baltic-racing/ADaMM-Accumulator-Distribution-and-Managment-Master/BOM/tsac-distribution.xlsx

Sheet: tsac-distribution
DA | Part number | Description | Designator | Footprint | Quantity | Value | Voltage | wurde ausreichend Bestellt?
 | MicroFit3.0 2-Pin | Molex MicroFit3.0 2-Pin | C1 | 43045-0212 | 1
 | 581-06036A101GAT2A | Capacitor with multiple Footprints | C2 | CAP 0603/1608 | 1 | 100p | 6.3V | ja
 | 885012206046 | Capacitor with multiple Footprints | C3, C4, C5, C6, C10, C14, C15, C18, C19, C20, C21, C25, C32, C35, C37, C39, C43, C44, C45, C46, C48, C54, C58, C63, C64, C67, C72, C79, C82 | CAP 0603/1608 | 29 | 100n | 6.3V | ja
? | 81-GRM1887U0J333JA1D | 33nF | C7 | CAP 0603/1608 | 1 | 37n | 6.3V | nein
 | MicroFit3.0 4-Pin | Molex Micro-Fit 3.0 4-Pin 600V 8.5V | C8 | 43045-0412 | 1
 | 885012206046 | Capacitor with multiple Footprints | C11, C71 | CAP 0603/1608 | 2 | 100n |  | ja
 | 885012208069 | Capacitor with multiple Footprints | C12, C27, C34, C81, C9 | CAP 1206/3216 | 5 | 10u | 25V | ja
 | MicroFit3.0 6-Pin | Molex MicroFit3.0 6-Pin | C13 | 43045-0612 | 1
 | MicroFit3.0 3-Pin | Molex MicroFit3.0 3-Pin | C16 | 43650-0315 | 1
 | 885012208003 | Capacitor with multiple Footprints | C17, C65, C66 | CAP 1206/3216 | 3 | 10u | 6.3V | ja
 | 80-C0805C105K9P | Capacitor with multiple Footprints | C22, C23, C24, C26, C29, C30, C31, C33, C47, C53, C80 | CAP 0805/2012 | 11 | 1u | 6.3V | ja
 |  | Capacitor with multiple Footprints | C28, C70 | CAP 1206/3216 | 2 | 0 F | 6.3V | ?
 | TO DO | Capacitor with multiple Footprints | C36, C83 | CAP 1206/3216 | 2 | TODO | 6.3V | ?
 | MicroFit3.0 8-Pin | Molex Micro-Fit 3.0 8-Pin 600V 8.5V | C38 | 43045-0812 | 1
 | 581-06036A220JAT2A | Capacitor with multiple Footprints | C40, C41 | CAP 0603/1608 | 2 | 22p | 6.3V | ja
 | 885012207002 | Capacitor with multiple Footprints | C42 | CAP 0805/2012 | 1 | 4u7 | 6.3V | ja
 | 885012207001 | Capacitor with multiple Footprints | C49, C50 | CAP 0805/2012 | 2 | 2u2 | 6.3V | ja
 | MicroFit3.0 4-Pin | Molex Micro-Fit 3.0 4-Pin 600V 8.5V | C51 | 43045-0412 | 1
 | 885012107015 | Capacitor with multiple Footprints | C52 | CAP 0805/2012 | 1 | 1u | 25V | ja
 | MicroFit3.0 3-Pin | Molex MicroFit3.0 3-Pin | C55 | 43650-0315 | 1
 | 890493425009CS | WCAP-FTBE Film Capacitors, 18x8.5x15mm, 1000V DC, 0.1 uF | C57 | WCAP-FTBE_18x8.5x15 | 1 | 0.1 uF | 1000v | ja
 | MicroFit3.0 10-Pin | Micro-Fit 3.0 10-Pin 600V 8.5V | C59 | 43045-1012 | 1
 | MicroFit3.0 3-Pin | Molex MicroFit3.0 3-Pin | C60 | 43650-0315 | 1
 | SN65HVD232 | Standard CAN-Transciever 3.3V | CT1, CT2 | SOIC8 CAN-Transceiver | 2
 | BAS16HT1G | Switching Diode, 2-Pin SOD-323, Pb-Free, Tape and Reel | D1, D3, D4, D5, D6, D7, D8, D10, D12, D13, D14, D15 | ONSC-SOD-323-2-477-02_V | 12
 | S1MB-13-F | Surface Mount Glass Passivated Rectifier , 1 A, 1.1 V, -65 to 150 degC, 2-Pin SMD, RoHS, Tape and Reel | D2, D9, D11 | DIOD-SMB-2_V | 3
 | 150060RS75020 | SMT Mono-color Chip LED Waterclear WL-SMCW, size 0603, Red, 2 V, 140 deg, 100 mcd | D16 | WL-SMCW_0603_H=0.25 | 1
 | 150060YS75020 | SMT Mono-color Chip LED Waterclear WL-SMCW, size 0603, Yellow, 2 V, 140 deg, 130 mcd | D17 | WL-SMCW_0603_H=0.25 | 1
 | 150060GS75020 | SMT Mono-color Chip LED Waterclear WL-SMCW, size 0603, Green, 3.2 V, 140 deg, 700 mcd | D18 | WL-SMCW_0603_H=0.25 | 1
 | STTH208UFY | DIODE GEN PURP 800V 2A SMBFLAT | D22, D23 | FP-SMBflat-MFG | 2
 | 150353RS74500 | WL-SMDC SMT Mono-color Ceramic LED Waterclear, size 3535, 2.2V, Red | D24 | WL-SMDC_3535 | 1
 | 7447709152 | WE-PD SMT Shielded Power Inductor, size 1210, 1500 uH, 0.8 A | L1 | WE-PD_1210_Metal base | 1 | 1500 uH, 0.8 A |  | ja
 | BIVAR SMFLP |  | LP1 | BIVAR_SMFLP | 1
 | IXTA08N100D2HV | D2 Series - 100V - 1700V N-Channel Depletion Mode Power MOSFETs, TO-263HV, RoHS | M1 | IXYS_TO-263HV | 1
 | R2S-2405/H | 2W DC/DC-Converter 'ECONOLINE' SMD 3kV unreg; V. In: 24; V. Out: 05; mA. Out: 400 | PS1, PS2 | RECOM_R2S | 2
 | R2S-2424/H | 2W DC/DC-Converter 'ECONOLINE' SMD 3kV unreg; V. In: 24; V. Out: 24; mA. Out: 83 | PS3 | RECOM_R2S | 1
 | BC857C | PNP Silicon AF Transistor, 45 V VCEO, 100 mA IC, SOT23, Reel, Green | Q1 | INF-SOT23_N | 1
 | BC847C | NPN Silicon AF Transistor, 45 V VCEO, 100 mA IC, SOT23, Reel, Green | Q2, Q5, Q7, Q9, Q12 | INF-SOT23_L | 5
 | DMP3098L-7 | P-Channel Enhancement Mode MOSFET, -30 V VDS, -55 to 155 degC, 3-Pin SOT23, RoHS, Tape and Reel | Q3 | DIOD-SOT23-3_V | 1
 | DMP4065S-7 | MOSFET P-CH 40V 2.4A SOT23 | Q4, Q6, Q8, Q11 | FP-SOT23-MFG | 4
 | IRLML0100TR | N-Channel MOSFET RK7002BMT116: 250mA, 60Vds, 20Vgs IRLML0100TR: 1.6A, 100Vds, 16Vgs | Q10 | SOT23 | 1
 | 71-CRCW06031K00FKEAC | Resistor with multiple footprints | R1, R2, R7, R22, R46, R49, R60, R61, R66, R67, R68, R69, R70, R71, R72 | STACKPOLE CSR0603 | 15 | 1k |  | ja
 | TO DO | Resistor with multiple footprints | R3, R15, R17 | STACKPOLE CSR0603 | 3 | See Note |  | ?
 | 755-SFR03EZPF1002 | Resistor with multiple footprints | R4, R9, R14, R16, R19, R25, R29, R37, R38, R39, R40, R42, R43, R47, R50, R65, R74, R78, R80 | STACKPOLE CSR0603 | 19 | 10k |  | ja
 | 603-RC0603JR-1322RL | Resistor with multiple footprints | R5, R6 | STACKPOLE CSR0603 | 2 | 22 |  | ja
 | TO DO | Resistor with multiple footprints | R8, R10, R73, R77 | STACKPOLE CSR0603 | 4 | TODO |  | ?
 | 667-ERA-3VEB3001V | Resistor with multiple footprints | R11 | STACKPOLE CSR0603 | 1 | 3k |  | ja
 |  | Resistor with multiple footprints | R12 | STACKPOLE CSR0603 | 1 | 4,7k |  | nein? Falls Deckungsgleich mit 4k7 eventuell genug überschuss
 | 667-ERA-3VEB1200V | Resistor with multiple footprints | R13 | STACKPOLE CSR0603 | 1 | 120 |  | ja
 | 652-CR0603FX-1501ELF | Resistor with multiple footprints | R18, R48, R51 | STACKPOLE CSR0603 | 3 | 1k5 |  | ja
 | 667-ERJ-UP3J680V | Resistor with multiple footprints | R20, R21 | STACKPOLE CSR0603 | 2 | 68 |  | ja
 | 667-ERJ-S03J155V | Resistor with multiple footprints | R23 | STACKPOLE CSR0603 | 1 | 1M5 |  | ja
 | CHV2512-FX-1005ELF | Res Thick Film 2512 10M Ohm 1% 1W ±100ppm/°C Molded SMD Paper T/R | R24, R31 | BOURNS_CHV2512 | 2
 | 71-TNPW060355K6BEEA | Resistor with multiple footprints | R26, R33 | STACKPOLE CSR0603 | 2 | 55k6 |  | ja
 | 603-RC0603JR-100RL | Resistor with multiple footprints | R27, R32, R45, R55, R64 | STACKPOLE CSR0603 | 5 | 0 |  | ja
 | 603-RC0603FR-1047KL | Resistor with multiple footprints | R28 | STACKPOLE CSR0603 | 1 | 47k |  | ja
 | 71-CRCW06033K30FKEAC | Resistor with multiple footprints | R30 | STACKPOLE CSR0603 | 1 | 3k3 |  | ja
 | 71-CRCW06032K20FKEAH | Resistor with multiple footprints | R34, R62 | STACKPOLE CSR0603 | 2 | 2k2 |  | nein, eventuell Überschuss anderer Platine Verwendbar
 | 594-PTCEL13R501RBE | PTCEL Series 1000 V 500 Ohm ±30 % Radial Inrush Current Limiter PTC Thermistor | R35, R36 | PTCEL17 | 2 |  |  | Durch Leon Gesponsert, Unklar ob eingetroffen
 | 71-CRCW06034K70JNEBC | Resistor with multiple footprints | R41, R44, R76, R81 | STACKPOLE CSR0603 | 4 | 4k7 |  | ja
 | 667-ERJ-S03J5R6V | Resistor with multiple footprints | R52 | STACKPOLE CSR0603 | 1 | 5.6 |  | ja
 | 667-ERJ-PA3J203V | Resistor with multiple footprints | R53 | STACKPOLE CSR0603 | 1 | 20k |  | nein, eventuell Überschuss anderer Platine Verwendbar
 | nicht beschafft | Resistor with multiple footprints | R54 | STACKPOLE CSR0603 | 1 | 47 |  | nein
 | 279-CRGP1206F15R | Resistor with multiple footprints | R56, R57, R58 | STACKPOLE CSR1206 | 3 | 15 |  | ja
 | OFFEN | Resistor with multiple footprints | R63 | STACKPOLE CSR0603 | 1 | OPEN |  | ?
 | 603-RC0603FR-1022KL | Resistor with multiple footprints | R75 | STACKPOLE CSR0603 | 1 | 22k |  | ja
 | KT24-1A-40L-THT | Reed Relay, Kt Series, 24 Vdc, 1.8 Kohm, 1 A, 1 Kv, Spst-No Rohs Compliant: Yes | R79 | STANDEX_KT_THT | 1
 | 750110055 | Würth Toroid Transformer 1:1 70µH | T1 | Wuerth_750110055 | 1
 | LTC6820HMS#PBF | IsoSPI Isolated Communication Interface, 2.7 to 5.5 V, -40 to 125 degC, 16-Pin MSOP (MS), Pb-Free | U1 | LT-MS-16_M | 1
 | SN74LVC1G74DCUT | Single Positive-Edge-Triggered D-Type Flip-Flop With Clear and Preset, DCU0008A, SMALL T&R | U2 | DCU0008A_L | 1
 | TCLT1000 | Optocoupler, Phototransistor Output, VCEO 70 V, -55 to 100 degC, 4-Pin SOP (SOP4L), RoHS, Tape and Reel | U3, U22 | VISH-SOP4L-4_V | 2
 | UCC3946D | Microprocessor supervisor with watchdog timer | U4 | SOIC8 | 1
 | ADCMP393ARUZ | 2.3V-5.5V Quad Comparator With Known Power-Up State and Open-Drain output | U5 | ANALOG_RU14 | 1
 | SN74LVC2G14DBVR | Dual Schmitt-Trigger Inverter, DBV0006A, LARGE T&R | U6 | DBV0006A_M | 1
 | SN74LVC1G74DCUT | Single Positive-Edge-Triggered D-Type Flip-Flop With Clear and Preset, DCU0008A, SMALL T&R | U7 | DCU0008A_N | 1
 | SN74HC86PWR | Quadruple 2-Input Exclusive-OR Gates, PW0014A, LARGE T&R | U8 | PW0014A_M | 1
 | CD4072BPW | CMOS Dual 4-Input OR Gate, PW0014A, TUBE | U9 | PW0014A_M | 1
 | SN74LVC2G02DCUR | NOR Gate IC 2 Channel 8-VSSOP | U10 | FP-DCU0008A-MFG | 1
 | SN74AHCT1G32DCKR | Single 2-Input Positive-OR Gate, DCK0005A, LARGE T&R | U11 | DCK0005A_M | 1
 | SN74LV08APW | Quadruple 2-Input Positive-AND Gates, PW0014A, TUBE | U12 | PW0014A_N | 1
 | SN74LVC1G14DCKR | Single Schmitt-Trigger Inverter, DCK0005A, LARGE T&R | U13 | DCK0005A_L | 1
 | ADUM3190 | ANALOG DEVICES - ADUM3190ARQZ - Isolation Amplifier, High Stability Error, 2 Amplifier, 2.5 kV, 3V to 20V, QSOP, 16 Pins | U14, U16 | AD_RQ_16 | 2
 | ADCMP391ARZ | 2.3V-5.5V Single Comparator With Known Power-Up State and Open-Drain output | U15 | ANALOG_R8 | 1
 | STM32F205RBT6 | ARM Cortex-M3 32-bit MCU, 128 KB Flash, 64 KB Internal RAM, 51 I/Os, 64-pin LQFP, -40 to 85 degC, Tray | U17 | STM-LQFP64_L | 1
 | R-78E3.3-1.0 | Nonisolated 3.3V Switchmode converter | U18 | SIP3_RECOM | 1
 | VIPER06 | Energy saving high voltage converter for direct feedback | U24 | SSO10_VIPER06 | 1
 | SN74LVC1G74DCUR | Single Positive-Edge-Triggered D-Type Flip-Flop With Clear and Preset, DCU0008A, LARGE T&R | U26 | DCU0008A_L | 1
 | 830035268 | WE-XTAL Quartz Crystal, SMT, CFPX-180, 25MHz, +/-50ppm | Y1 | WE-XTAL_CFPX-180 | 1 |  |  | ja
 | 652-CHV2512FX1005ELF |  |  |  | 1 | 10M |  | ja
 | 81-GRM1887U0J333JA1D |  |  |  | 1 | 33nF | 6.3V | ja
 | 750110055 | Würth Toroid Transformer 1:1 70µH |  |  | 1 |  |  | ja

Sheet: Suchliste
DA | Part number | Description | Designator | Footprint | Quantity | Value
 |  | Capacitor with multiple Footprints | C28, C70 | CAP 1206/3216 | 2 | 0 F | 6.3V
 | 581-06036A220JAT2A | Capacitor with multiple Footprints | C40, C41 | CAP 0603/1608 | 2 | 22p | 6.3V
 | SN65HVD232 | Standard CAN-Transciever 3.3V | CT1, CT2 | SOIC8 CAN-Transceiver | 2
 | 150060RS75020 | SMT Mono-color Chip LED Waterclear WL-SMCW, size 0603, Red, 2 V, 140 deg, 100 mcd | D16 | WL-SMCW_0603_H=0.25 | 1
 | 150060GS75020 | SMT Mono-color Chip LED Waterclear WL-SMCW, size 0603, Green, 3.2 V, 140 deg, 700 mcd | D18 | WL-SMCW_0603_H=0.25 | 1
 | STTH208UFY | DIODE GEN PURP 800V 2A SMBFLAT | D22, D23 | FP-SMBflat-MFG | 2
 | DMP4065S-7 | MOSFET P-CH 40V 2.4A SOT23 | Q4, Q6, Q8, Q11 | FP-SOT23-MFG | 4
 | 667-ERA-3VEB1200V | Resistor with multiple footprints | R13 | STACKPOLE CSR0603 | 1 | 120
 | 667-ERJ-UP3J680V | Resistor with multiple footprints | R20, R21 | STACKPOLE CSR0603 | 2 | 68
 | CHV2512-FX-1005ELF | Res Thick Film 2512 10M Ohm 1% 1W ±100ppm/°C Molded SMD Paper T/R | R24, R31 | BOURNS_CHV2512 | 2
 | 71-CRCW06032K20FKEAH | Resistor with multiple footprints | R34, R62 | STACKPOLE CSR0603 | 2 | 2k2
 | 594-PTCEL13R501RBE | PTCEL Series 1000 V 500 Ohm ±30 % Radial Inrush Current Limiter PTC Thermistor | R35, R36 | PTCEL17 | 2
 | 750110055 | Würth Toroid Transformer 1:1 70µH | T1 | Wuerth_750110055 | 1
 | LTC6820HMS#PBF | IsoSPI Isolated Communication Interface, 2.7 to 5.5 V, -40 to 125 degC, 16-Pin MSOP (MS), Pb-Free | U1 | LT-MS-16_M | 1
 | SN74LVC1G74DCUT | Single Positive-Edge-Triggered D-Type Flip-Flop With Clear and Preset, DCU0008A, SMALL T&R | U2 | DCU0008A_L | 1
 | ADCMP393ARUZ | 2.3V-5.5V Quad Comparator With Known Power-Up State and Open-Drain output | U5 | ANALOG_RU14 | 1
 | SN74LVC2G02DCUR | NOR Gate IC 2 Channel 8-VSSOP | U10 | FP-DCU0008A-MFG | 1
 | SN74LVC1G14DCKR | Single Schmitt-Trigger Inverter, DCK0005A, LARGE T&R | U13 | DCK0005A_L | 1
 | R-78E3.3-1.0 | Nonisolated 3.3V Switchmode converter | U18 | SIP3_RECOM | 1
 | SN74LVC1G74DCUR | Single Positive-Edge-Triggered D-Type Flip-Flop With Clear and Preset, DCU0008A, LARGE T&R | U26 | DCU0008A_L | 1
 | 652-CHV2512FX1005ELF |  |  |  | 1 | 10M
