baltic-racing/ADaMM-Accumulator-Distribution-and-Managment-Master/hv-measurement.pdf

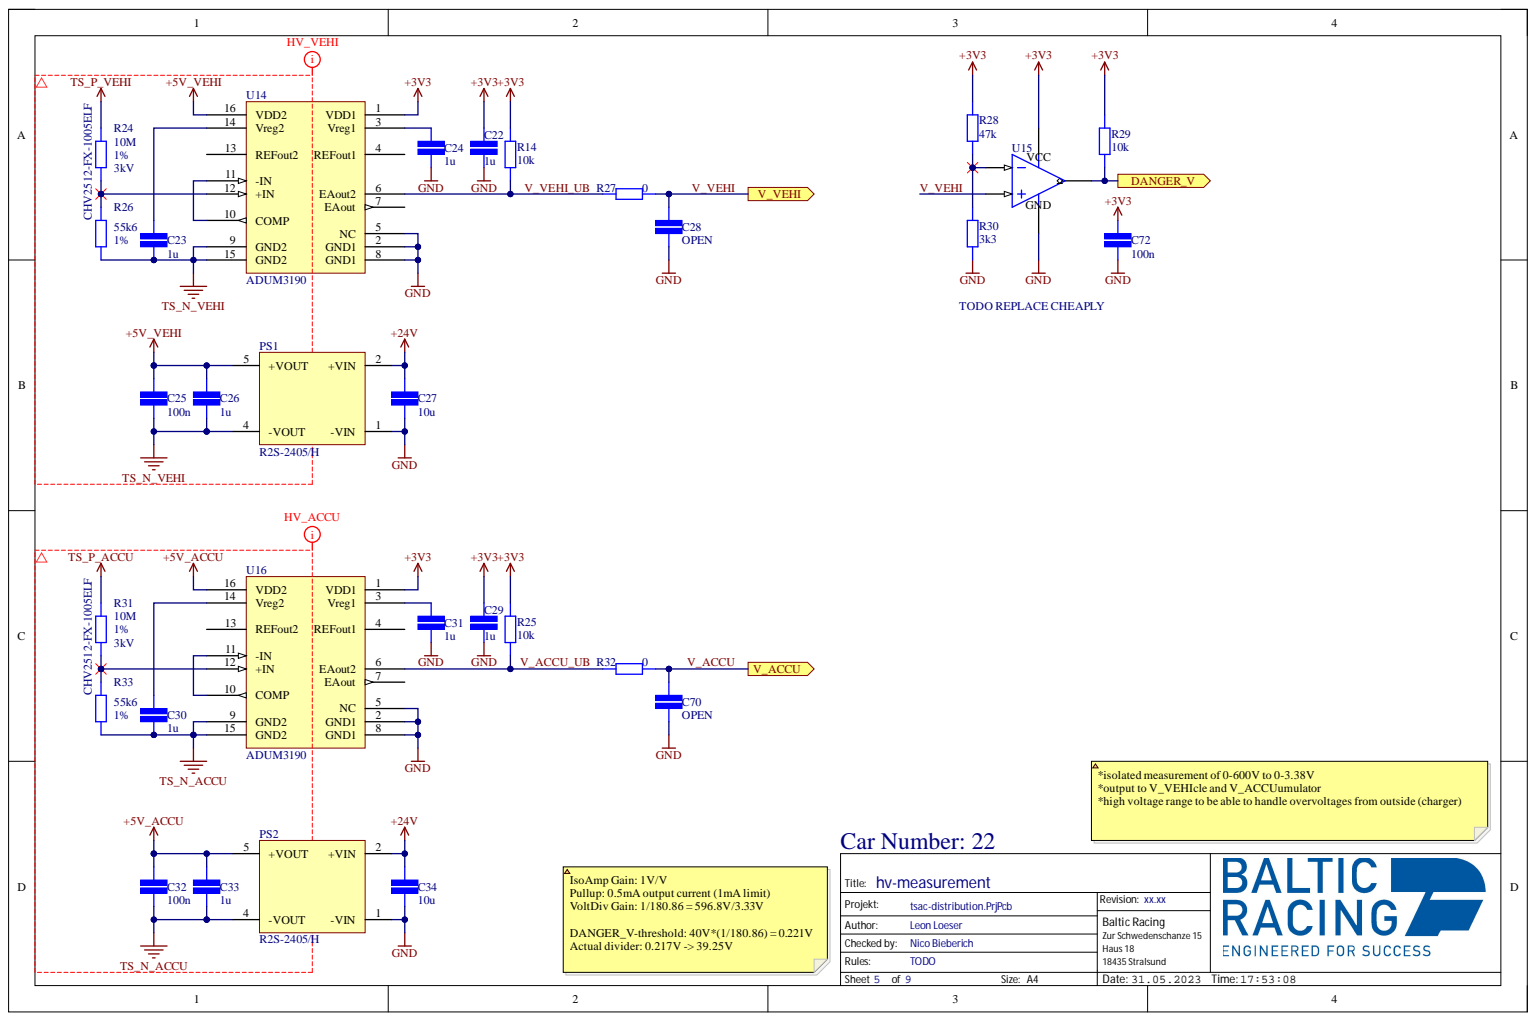
[picture p1: page 1]

REFout2 13

COMP 10

1u | GND2 15

*isolated measurement of 0-600V to 0-3.38V
*output to V_VEHIcle and V_ACCUumulator
*high voltage range to be able to handle overvoltages from outside (charger)

IsoAmp Gain: 1V/V
Pullup: 0.5mA output current (1mA limit)
VoltDiv Gain: 1/180.86 = 596.8V/3.33V
