baltic-racing/ADaMM-Accumulator-Distribution-and-Managment-Master/air.pdf

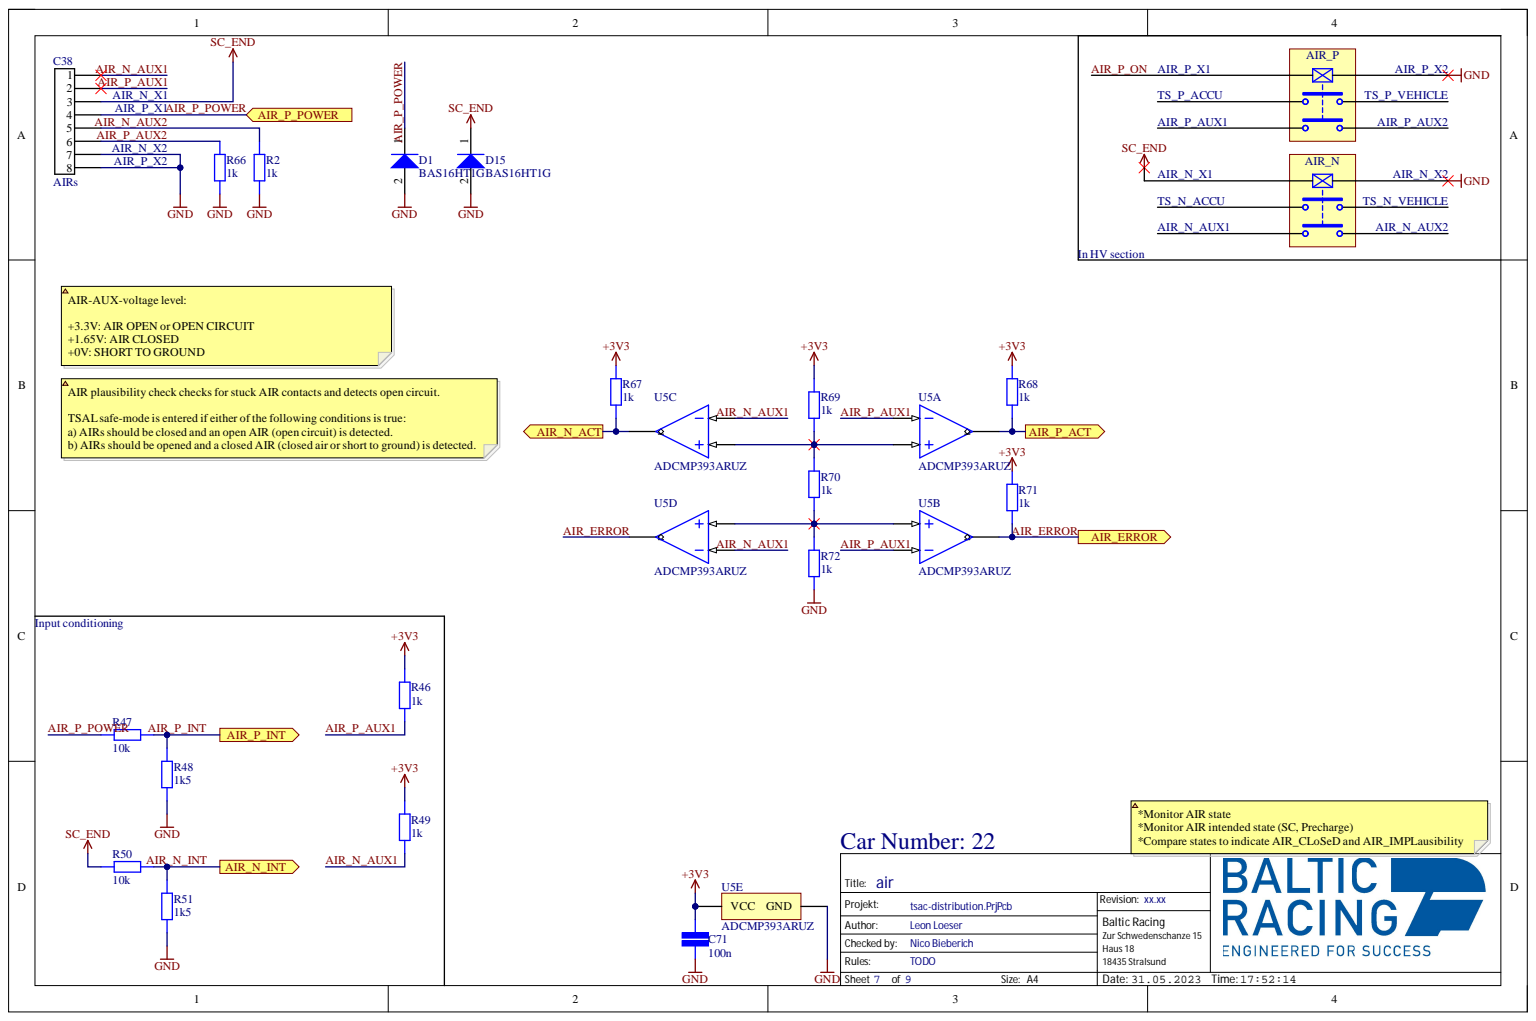
[picture p2: page 1]

AIR_P_AUX2
AIR_N_X2

AIR-AUX-voltage level:

+3.3V: AIR OPEN or OPEN CIRCUIT
+1.65V: AIR CLOSED
+0V: SHORT TO GROUND

AIR plausibility check checks for stuck AIR contacts and detects open circuit.

TSALsafe-mode is entered if either of the following conditions is true:
a) AIRsshould be closed and an open AIR (open circuit) is detected.
b) AIRsshould be opened and a closed AIR (closed air or short to ground) is detected.

*Monitor AIR state
*Monitor AIR intended state (SC, Precharge)
*Compare states to indicate AIR_CLoSeD and AIR_IMPLausibility
