baltic-racing/ADaMM-Accumulator-Distribution-and-Managment-Master/tsal-logic.pdf

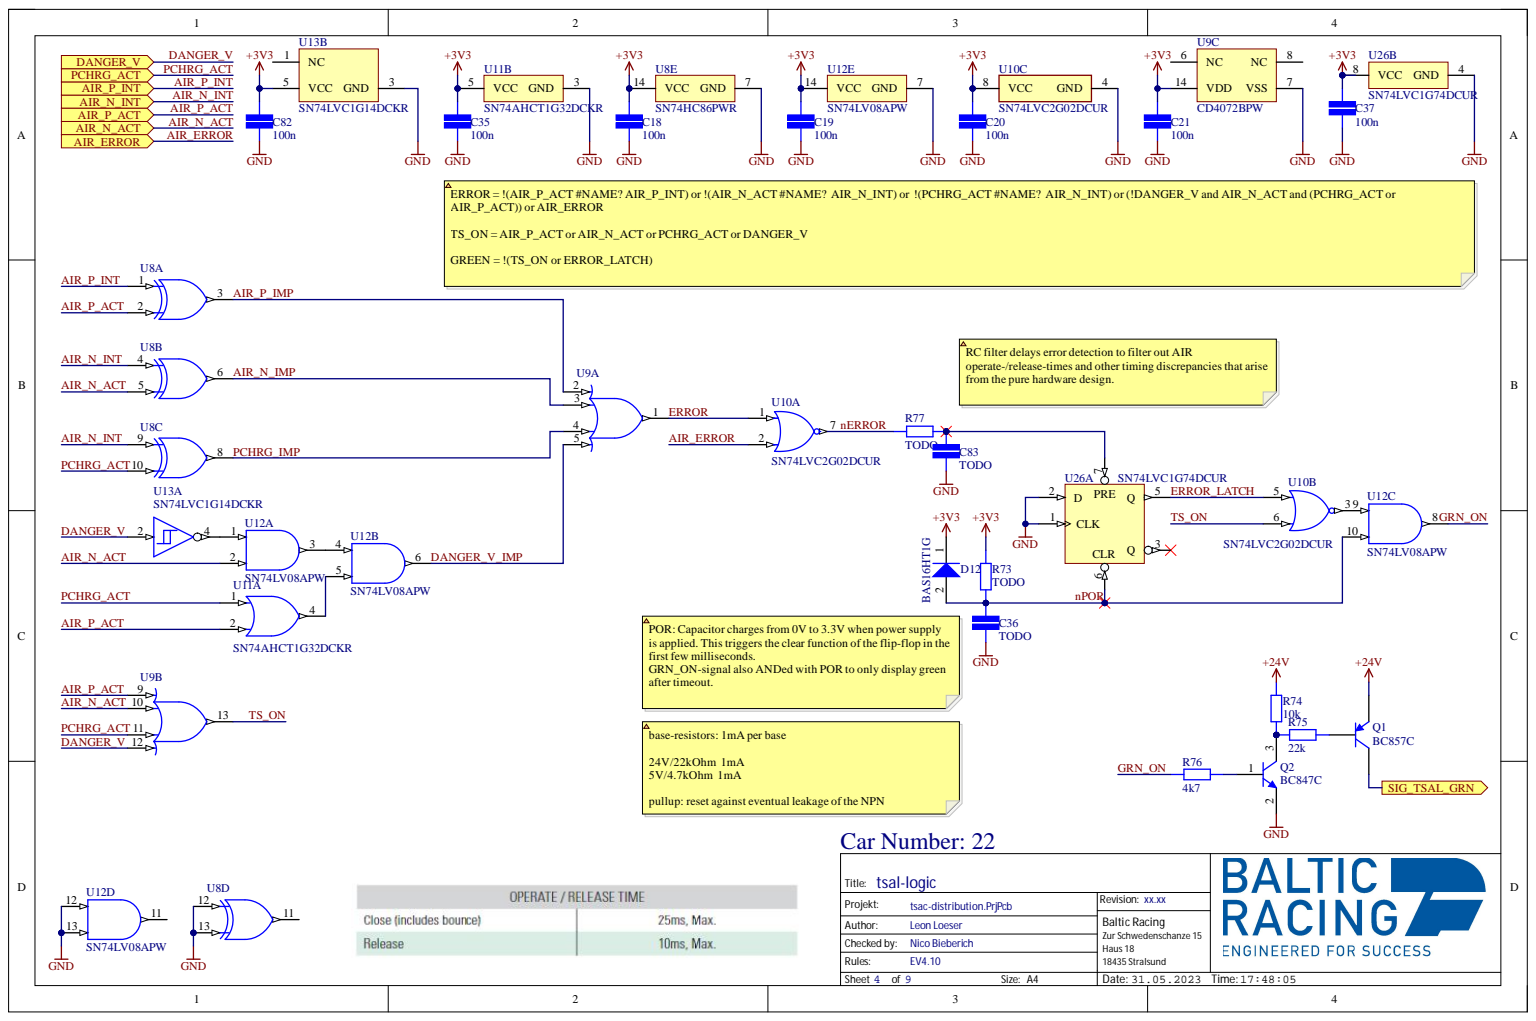
[picture p3: page 1]

ERROR = !(AIR_P_ACT #NAME? AIR_P_INT) or !(AIR_N_ACT #NAME? AIR_N_INT) or !(PCHRG_ACT #NAME? AIR_N_INT) or (!DANGER_V and AIR_N_ACT and (PCHRG_ACT or
AIR_P_ACT)) or AIR_ERROR

RC filter delays error detection to filter out AIR
operate-/release-times and other timing discrepancies that arise
from the pure hardware design.

POR: Capacitor charges from 0V to 3.3V when power supply
is applied. This triggersthe clear function of the flip-flop in the
first few milliseconds.
GRN_ON-signal also ANDed with POR to only display green
after timeout.

base-resistors: 1mA per base

pullup: reset against eventual leakage of the NPN
