baltic-racing/ADaMM-Accumulator-Distribution-and-Managment-Master/precharge.pdf

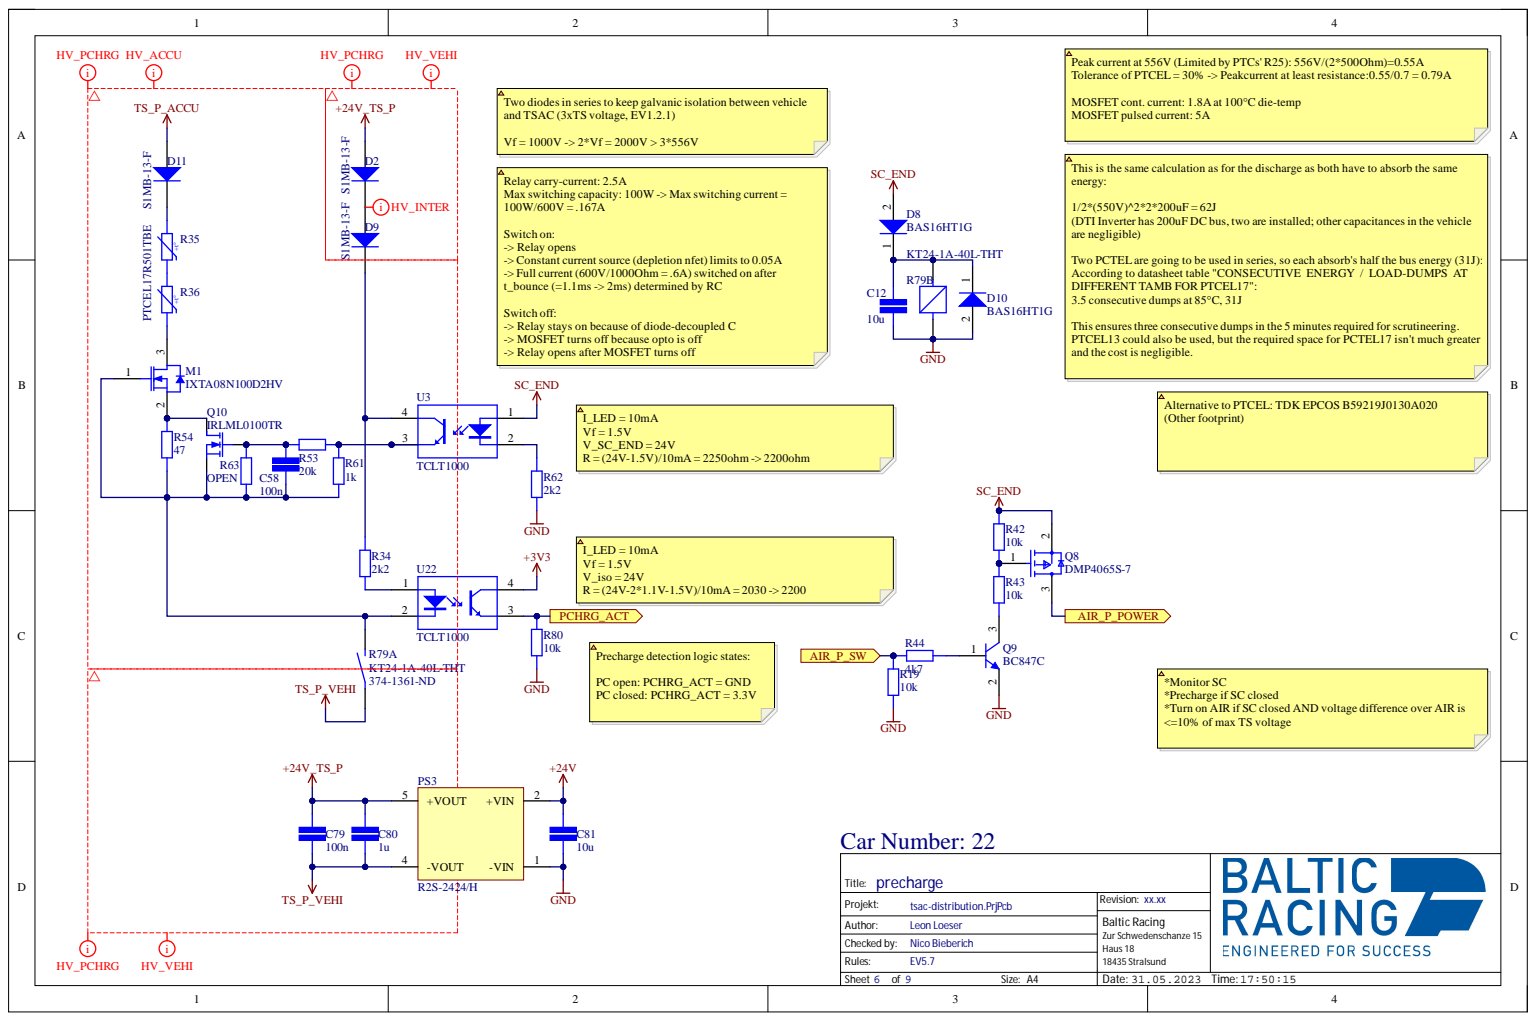
[picture p4: page 1]
