baltic-racing/ADaMM-Accumulator-Distribution-and-Managment-Master/simulation/precharge/precharge_currentlimit_relay.asc

C1: cap; 10µ
C2: cap; 100n
D1: schottky; 1N5819
D2: diode
D3: schottky; 1N5817
L1: ind; 430m; Rser=1800
R1: res; 20k
R2: res; 1k
V1: voltage; PULSE(0 24 0 10n 10n .5 1)
V2: voltage; PULSE(0 5-3*1.1 0 10n 10n .5 1)
Named nets: 0
.tran 1.5
