baltic-racing/ADaMM-Accumulator-Distribution-and-Managment-Master/simulation/precharge/capacitor-precharge.asc

C1: cap; 400µ; IC=0V
R1: res; 1000
V1: voltage; 550
Named nets: 0
.tran 5
