baltic-racing/ADaMM-Accumulator-Distribution-and-Managment-Master/simulation/precharge/precharge.asc

C1: cap; 400µ
D1: diode; RFN10NS8D
D2: diode; RFU02VS8S
R1: res; 1k
R4: res; 10k
S1: sw; Switch1
U1: PC817A
V1: voltage; PWL(0 0 1 0 1.000001 5)
V2: voltage; 5
Vts1: voltage; 550; Rser=100
Vts2: voltage; 5; Rser=1m
Named nets: GND_ISO, Vout, GND_ISO_HV, 0
.tran 0 3 0 startup
.model Switch1 SW(Ron=1 Roff=1Meg Vt=2.5 Vh=.2)
