baltic-racing/ADaMM-Accumulator-Distribution-and-Managment-Master/(list of files, drawings)

Other design files:
air.SchDoc
ams.SchDoc
hv-indicator.SchDoc
hv-measurement.SchDoc
imd-monitoring.SchDoc
microcontroller.SchDoc
precharge.SchDoc
tsac-distribution.PcbDoc
tsac-distribution.PrjPcb
tsac-distribution.SchDoc
tsal-logic.SchDoc
