baltic-racing/ADaMM-Accumulator-Distribution-and-Managment-Master/(commit log)

2021-10-14 Start project structure; STart adjusting to rules
    [air.SchDoc, ams-master.SchDoc, dcdc-switch.SchDoc, hv-measurement.SchDoc, imd-monitoring.SchDoc, microcontroller.SchDoc, precharge.SchDoc, tsac-distribution.PcbDoc]
2021-10-15 Redo hv-measurement w/ different IC; Redo air/tsal
    [air.SchDoc, ams-master.SchDoc, hv-measurement.SchDoc, tsac-distribution.PrjPcb, tsac-distribution.SchDoc, tsal-logic.SchDoc]
2021-10-15 Add hv-indicator; Finish DCDC, TSAL;
    [air.SchDoc, ams-master.SchDoc, ams.SchDoc, dcdc-switch.SchDoc, hv-indicator.SchDoc, hv-measurement.SchDoc, imd-monitoring.SchDoc, microcontroller.SchDoc]
2021-10-16 Replace diodes; Fix precharge; TODO: Micro, Layout
    [air.SchDoc, ams.SchDoc, dcdc-switch.SchDoc, hv-indicator.SchDoc, hv-measurement.SchDoc, imd-monitoring.SchDoc, microcontroller.SchDoc, precharge.SchDoc]
2021-10-16 Add netclasses, fix ISO1050
    [air.SchDoc, ams.SchDoc, dcdc-switch.SchDoc, hv-indicator.SchDoc, hv-measurement.SchDoc, imd-monitoring.SchDoc, precharge.SchDoc, tsac-distribution.PrjPcb]
2021-10-17 Add notes, replace SC relays with load switches
    [air.SchDoc, ams.SchDoc, dcdc-switch.SchDoc, hv-indicator.SchDoc, hv-measurement.SchDoc, imd-monitoring.SchDoc, microcontroller.SchDoc, precharge.SchDoc]
2021-10-24 Fix AIR bug; Fix IMD bug, variant; Route TSAL
    [air.SchDoc, ams.SchDoc, hv-measurement.SchDoc, imd-monitoring.SchDoc, microcontroller.SchDoc, tsac-distribution.PrjPcb, tsac-distribution.SchDoc, tsal-logic.SchDoc]
2021-10-24 Make precharge software-only; Remove 5V rail
    [air.SchDoc, ams.SchDoc, hv-measurement.SchDoc, microcontroller.SchDoc, precharge.SchDoc, tsac-distribution.SchDoc, tsal-logic.SchDoc]
2021-10-25 Add and connect ATSAM71; Start routing ATSAM71
    [ams.SchDoc, hv-indicator.SchDoc, microcontroller.SchDoc, tsac-distribution.SchDoc, tsal-logic.SchDoc]
2021-10-26 Start routing MCU; Add Würth XTAL
    [microcontroller.SchDoc, tsac-distribution.SchDoc]
2021-11-07 Redo precharge
    [dcdc-switch.SchDoc, microcontroller.SchDoc, precharge.SchDoc, tsac-distribution.SchDoc]
2021-11-09 Redo part of precharge again; Continue routing
    [precharge.SchDoc]
2021-12-01 Fixed TSAL according to rules, still have to route
    [ams.SchDoc, dcdc-switch.SchDoc, hv-measurement.SchDoc, imd-monitoring.SchDoc, precharge.SchDoc, tsac-distribution.PrjPcb, tsac-distribution.SchDoc, tsal-logic.SchDoc]
2021-12-05 Remove DCDC stuff; fix TSAL
    [dcdc-switch.SchDoc, tsac-distribution.PrjPcb, tsac-distribution.SchDoc, tsal-logic.SchDoc]
2021-12-06 Start layout rework
    [air.SchDoc, imd-monitoring.SchDoc, tsac-distribution.SchDoc]
2021-12-07 Changed power stages
    [air.SchDoc, ams.SchDoc, imd-monitoring.SchDoc, microcontroller.SchDoc, precharge.SchDoc]
2021-12-11 Route logic, CAN, SPI
    [ams.SchDoc, imd-monitoring.SchDoc, microcontroller.SchDoc, tsac-distribution.PrjPcb]
2021-12-12 Continue routing; Connect AIR_P_SW
    [microcontroller.SchDoc, precharge.SchDoc]
2022-01-15 Commit everything before MCU switch
    [ams.SchDoc, hv-measurement.SchDoc]
2022-01-18 Fixed LEDs, Started layout
    [microcontroller.SchDoc, precharge.SchDoc, tsac-distribution.SchDoc]
2022-02-05 added Voltage Paramter to all CAPS
    [ams.SchDoc, hv-indicator.SchDoc, hv-measurement.SchDoc, imd-monitoring.SchDoc, microcontroller.SchDoc, precharge.SchDoc, tsac-distribution.SchDoc, tsal-logic.SchDoc]
2022-02-14 Continue routing, change pinconnections
    [ams.SchDoc, microcontroller.SchDoc, tsac-distribution.PrjPcb]
2022-02-15 Finished routing. ToDo: Cleanup, silkscreen-markings
    [microcontroller.SchDoc]
2022-02-15 Finish Layout; Cleanup Warnings and DRC
    [air.SchDoc, ams.SchDoc, hv-measurement.SchDoc, imd-monitoring.SchDoc, microcontroller.SchDoc, tsac-distribution.PrjPcb, tsac-distribution.SchDoc, tsac-distribution.xlsx]
2022-02-16 Add grounded mounting-holes; Redo DRC; Ready2Review
2022-02-16 Reworked precharge to actually work ruleconforming. Ready2Review
    [precharge.SchDoc]
2022-03-02 Change DCDCs to R2S
    [hv-measurement.SchDoc, precharge.SchDoc, tsac-distribution.PrjPcb]
2022-03-20 Fix error in AIR detection
    [air.SchDoc]
2022-03-24 Remove stupid note
    [tsac-distribution.PrjPcb, tsal-logic.SchDoc]
2022-03-25 Add powerstage for ts activation
    [ams.SchDoc, imd-monitoring.SchDoc, microcontroller.SchDoc, tsac-distribution.PrjPcb, tsac-distribution.SchDoc]
2022-05-14 generated gerbers and modified gerber outjob
    [tsac-distribution.PrjPcb, tsac-distribution.xlsx]
2022-06-13 created new gerber files with board outline
    [tsac-distribution.PrjPcb]
2022-11-25 Added Print-Outjob-File
    Added Print-Outjob-File for internal manufacturing.
    [tsac-distribution.PrjPcb, tsac-distribution.xlsx]
2023-05-31 Added some schematic exports
    [air.SchDoc, hv-measurement.SchDoc, precharge.SchDoc, tsac-distribution.PrjPcb, tsal-logic.SchDoc]
2024-04-19 changes in the schematic
    updated the DC/DC
    [tsac-distribution.PrjPcb]
